byggarobot/wifi-environment-sensor-node/electronics/WiFi Environment Sensor Node Schematic.pdf

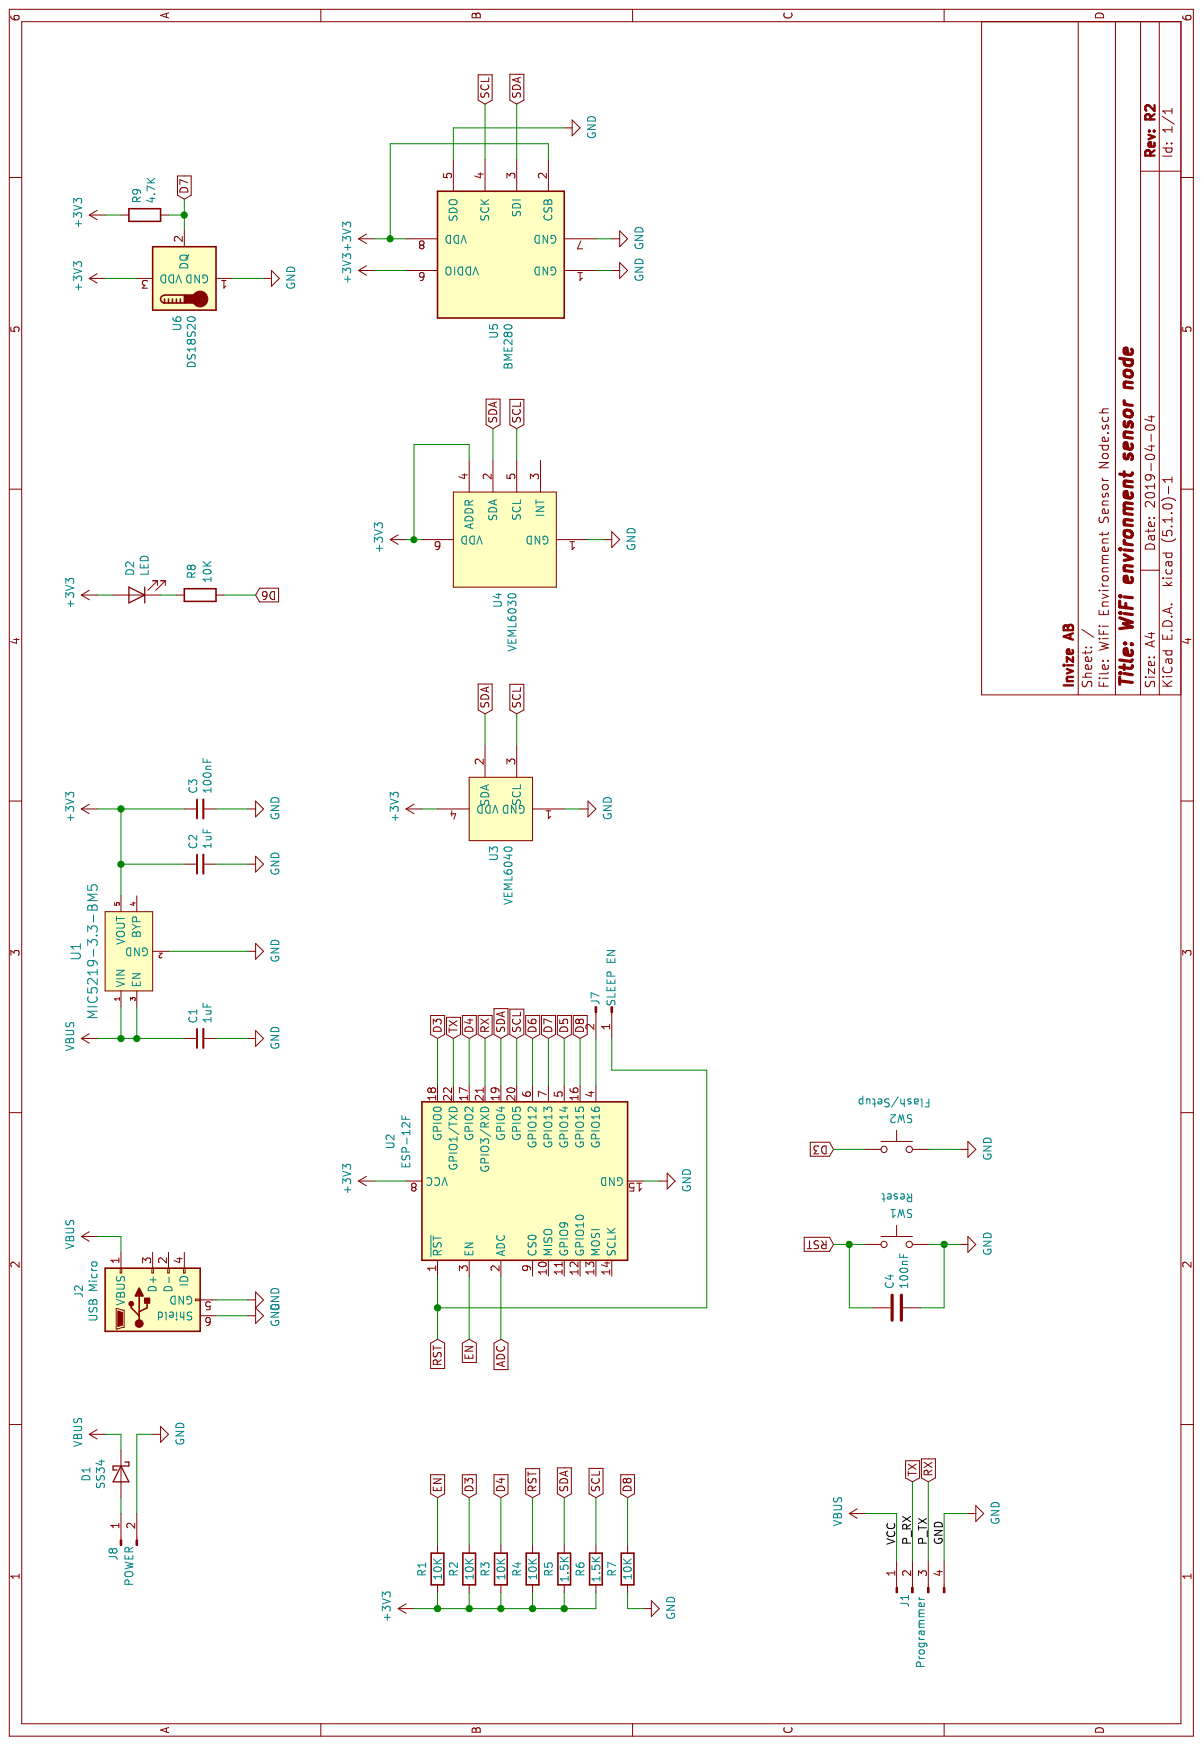
[picture p1: page 1]
