byggarobot/wifi-environment-sensor-node/(commit log)

2019-04-04 Second revision
    [WiFi Environment Sensor Node-B_Cu.gbr, WiFi Environment Sensor Node-B_Mask.gbr, WiFi Environment Sensor Node-B_Paste.gbr, WiFi Environment Sensor Node-B_SilkS.gbr, WiFi Environment Sensor Node-Edge_Cuts.gbr, WiFi Environment Sensor Node-F_Cu.gbr, WiFi Environment Sensor Node-F_Mask.gbr, WiFi Environment Sensor Node-F_Paste.gbr]
2019-04-05 Fix front silk screen of PCB
    [WiFi Environment Sensor Node-B_Cu.gbr, WiFi Environment Sensor Node-B_Mask.gbr, WiFi Environment Sensor Node-B_Paste.gbr, WiFi Environment Sensor Node-B_SilkS.gbr, WiFi Environment Sensor Node-Edge_Cuts.gbr, WiFi Environment Sensor Node-F_Cu.gbr, WiFi Environment Sensor Node-F_Mask.gbr, WiFi Environment Sensor Node-F_Paste.gbr]
2019-04-09 Move sleep enable jumper to better place and fix silk screen text
    [WiFi Environment Sensor Node-B_Cu.gbr, WiFi Environment Sensor Node-B_Mask.gbr, WiFi Environment Sensor Node-B_Paste.gbr, WiFi Environment Sensor Node-B_SilkS.gbr, WiFi Environment Sensor Node-Edge_Cuts.gbr, WiFi Environment Sensor Node-F_Cu.gbr, WiFi Environment Sensor Node-F_Mask.gbr, WiFi Environment Sensor Node-F_Paste.gbr]
